nicoverduin/CoilWinder/README.md

CoilWinder
==========

Files to construct my ColiWinder project using 3D printing
