nicoverduin/CoilWinder/BOM.xls

Item | Part Number | Thumbnail | BOM Structure | Unit QTY | QTY | Stock Number | Project | Description | #test
16 | 10252 | (NonDisplayable) | Normal | 1 | 1
17 | 13190 | (NonDisplayable) | Normal | 1 | 1
18 | 18001 | (NonDisplayable) | Normal | 1 | 1
8 | 2793 | (NonDisplayable) | Normal | 1 | 1
63 | ANSI B18.6.5M - M3x0.5 x 16 | *Varies* | Purchased | 1 | 10 |  |  | Cross Recessed Pan Head Tapping Screw - Type D - Type IA - Metric
66 | Bearring cap 8mm | (NonDisplayable) | Normal | 1 | 4
23 | Compress Spring1 | *Varies* | Normal | 1 | 4
14 | DC Motor stand V2 | (NonDisplayable) | Normal | 1 | 1
15 | DC motor | (NonDisplayable) | Normal | 1 | 1
79 | Drive coupling | (NonDisplayable) | Normal | 1 | 1
67 | ISO 1224 - 39 - 3 x 8 x 4 | (NonDisplayable) | Purchased | 1 | 4 |  |  | Rolling bearings - Instrument precision bearings
57 | ISO 7091 - ST 4 - 100 HV | (NonDisplayable) | Purchased | 1 | 4 |  |  | Plain washers - Normal series - Product grade C
6 | JIS B 1521 SKF (D) - SKF 608-Z | (NonDisplayable) | Purchased | 1 | 8 |  |  | Deep groove ball bearings single row with Z shield SKF
53 | M3 Washer | (NonDisplayable) | Purchased | 1 | 27 |  |  | M3 Washer
56 | M3 nut nickel plated | (NonDisplayable) | Purchased | 1 | 17 |  |  | Hex M3 Nut
55 | M4 nut nickel plated | (NonDisplayable) | Purchased | 1 | 4 |  |  | Hex M4 nut
72 | Nema 17 stepper motor | (NonDisplayable) | Normal | 1 | 1
73 | Nema 17 support plate | (NonDisplayable) | Normal | 1 | 1
61 | Nut M3 Torque nickel plated | (NonDisplayable) | Purchased | 1 | 3 |  |  | Hex M3 nut Torque
5 | Nut M8 | *Varies* | Purchased | 1 | 103 |  |  | Hex Nut
24 | Sensor stand | (NonDisplayable) | Normal | 1 | 1
60 | Tension Push washer | (NonDisplayable) | Normal | 1 | 2
64 | Tension Push washer backplate | (NonDisplayable) | Normal | 1 | 2
59 | Tension knob | (NonDisplayable) | Normal | 1 | 2
74 | Thread rod M8 x 100 mm | (NonDisplayable) | Normal | 1 | 2 |  |  | 420.000 mm
3 | Thread rod M8 x 150 mm | (NonDisplayable) | Normal | 1 | 6 |  |  | 420.000 mm
10 | Thread rod M8 x 190 mm | (NonDisplayable) | Normal | 1 | 1 |  |  | 420.000 mm
77 | Thread rod M8 x 250 mm | (NonDisplayable) | Normal | 1 | 5 |  |  | 420.000 mm
75 | Thread rod M8 x 300 mm | (NonDisplayable) | Normal | 1 | 4 |  |  | 420.000 mm
80 | Thread rod M8 x 410 mm | (NonDisplayable) | Normal | 1 | 2 |  |  | 410.000 mm
1 | Vertex Bootm with foot | (NonDisplayable) | Normal | 1 | 6
27 | Vertex Bottom tensioner left | (NonDisplayable) | Normal | 1 | 1
51 | Vertex Bottom tensioner right | (NonDisplayable) | Normal | 1 | 1
58 | Washer M4 | (NonDisplayable) | Purchased | 1 | 2 |  |  | Plain washers - Normal series - Product grade C
4 | Washer M8 | *Varies* | Purchased | 1 | 102 |  |  | Washer
52 | Wire guidance base assembly | (NonDisplayable) | Normal | 1 | 1 |  |  | see: wire guidance base assemble.STL
65 | Wire guidance wheelV2 | (NonDisplayable) | Normal | 1 | 2 |  |  | See: wire guidance wheel.STL
78 | bolt M3 x 12 nickel plated | (NonDisplayable) | Purchased | 1 | 8 |  |  | Cross recessed pan head thread forming screws
62 | bolt M3 x 30 nickel plated | (NonDisplayable) | Purchased | 1 | 1 |  |  | bolt M3 x 30
20 | bolt M4 x 50 | *Varies* | Purchased | 1 | 4 |  |  | M4 bolt long enough to hold everything
71 | carriage | (NonDisplayable) | Normal | 1 | 1
19 | coil holder 1 | (NonDisplayable) | Normal | 1 | 2
21 | connect stepper | (NonDisplayable) | Normal | 1 | 2
54 | felt pad | (NonDisplayable) | Normal | 1 | 4 |  |  | felt pad i.e. used under chairs
69 | guidance wheel | (NonDisplayable) | Normal | 1 | 1
70 | lineair bearing 8 x15 x 24 | (NonDisplayable) | Normal | 1 | 2
25 | optical sensor pcb | (NonDisplayable) | Normal | 1 | 1
2 | right top | (NonDisplayable) | Normal | 1 | 3
29 | slide rod | (NonDisplayable) | Normal | 1 | 2
68 | wire guide | (NonDisplayable) | Normal | 1 | 1
