nicoverduin/CoilWinder/3D Print STL Files/Wire guidance base assembly.stl

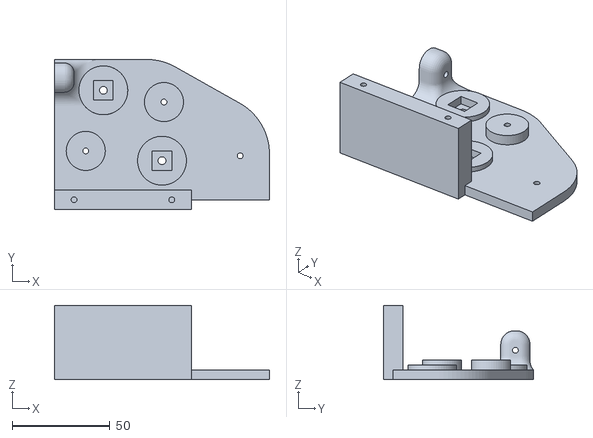
[picture p1: CAD file, 2014-01-01]
3D Print STL Files/Wire guidance base assembly.stl
110.0 x 76.8 x 38.0
