nicoverduin/CoilWinder/3D Print STL Files/Vertex Bottom tensioner right.stl

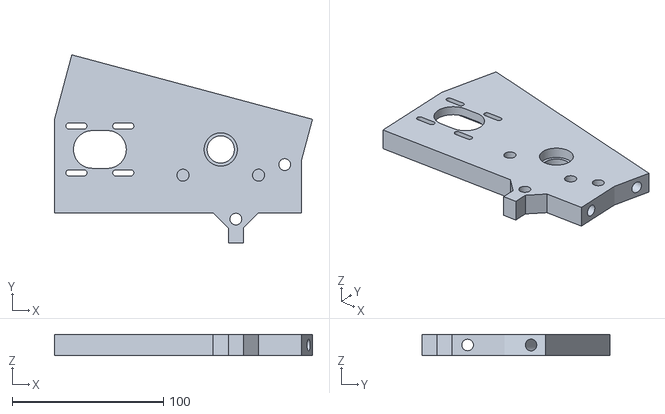
[picture p2: CAD file, 2014-01-01]
3D Print STL Files/Vertex Bottom tensioner right.stl
170.7 x 124.6 x 14.0
