nicoverduin/CoilWinder/3D Print STL Files/Tension knob.stl

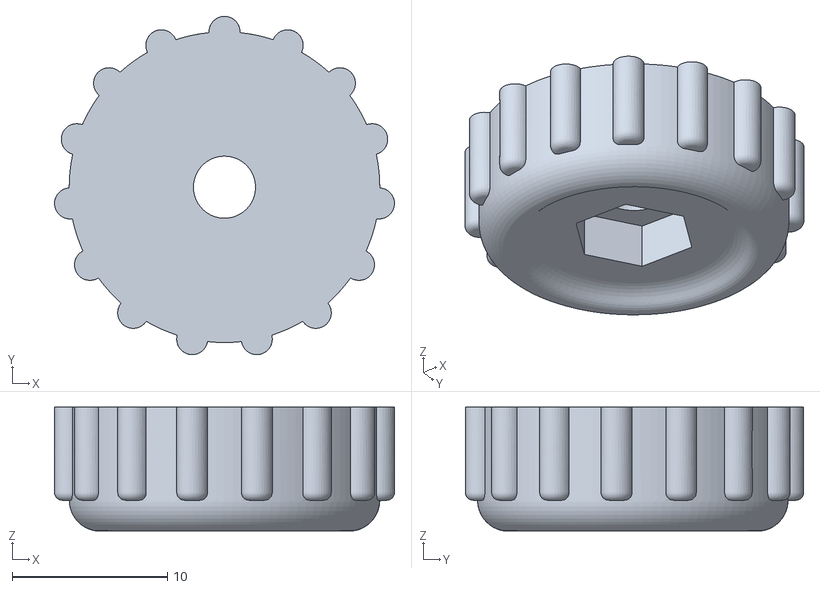
[picture p3: CAD file, 2014-01-01]
3D Print STL Files/Tension knob.stl
21.9 x 21.8 x 7.98
