nicoverduin/CoilWinder/3D Print STL Files/right top.stl

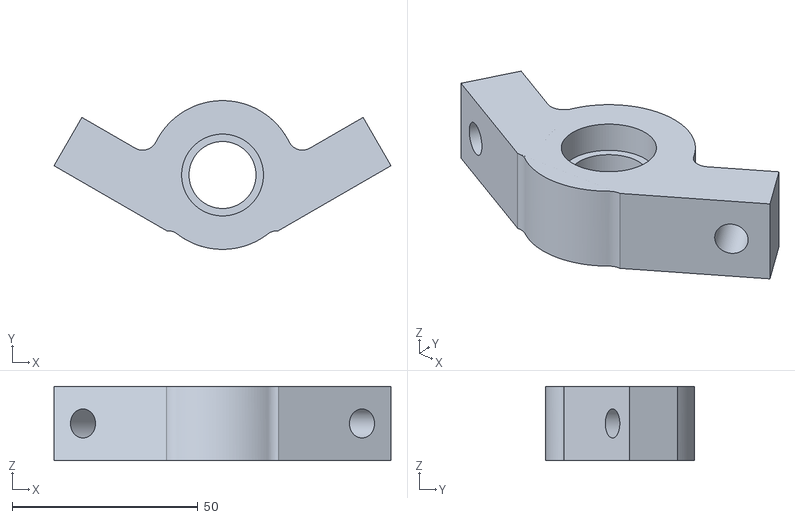
[picture p4: CAD file, 2014-01-01]
3D Print STL Files/right top.stl
90.6 x 40.0 x 20.0
