nicoverduin/CoilWinder/3D Print STL Files/DC Motor stand V2.stl

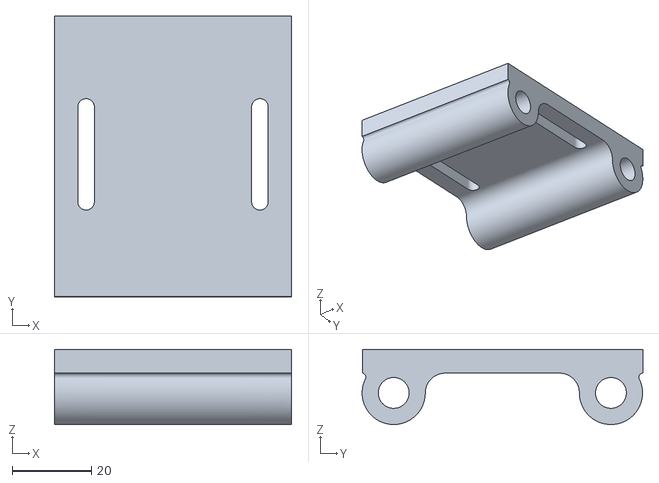
[picture p5: CAD file, 2014-01-01]
3D Print STL Files/DC Motor stand V2.stl
60.0 x 71.1 x 19.0
