nicoverduin/CoilWinder/3D Print STL Files/15-3m06m6ca6.stl

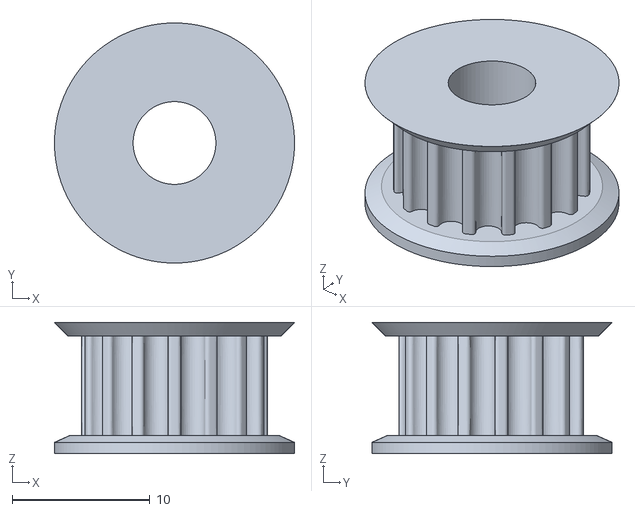
[picture p6: CAD file, 2014-01-01]
3D Print STL Files/15-3m06m6ca6.stl
17.4 x 17.4 x 9.50
