nicoverduin/CoilWinder/3D Print STL Files/Tensioner Pulley HTD 3 x 6 x 20.stl

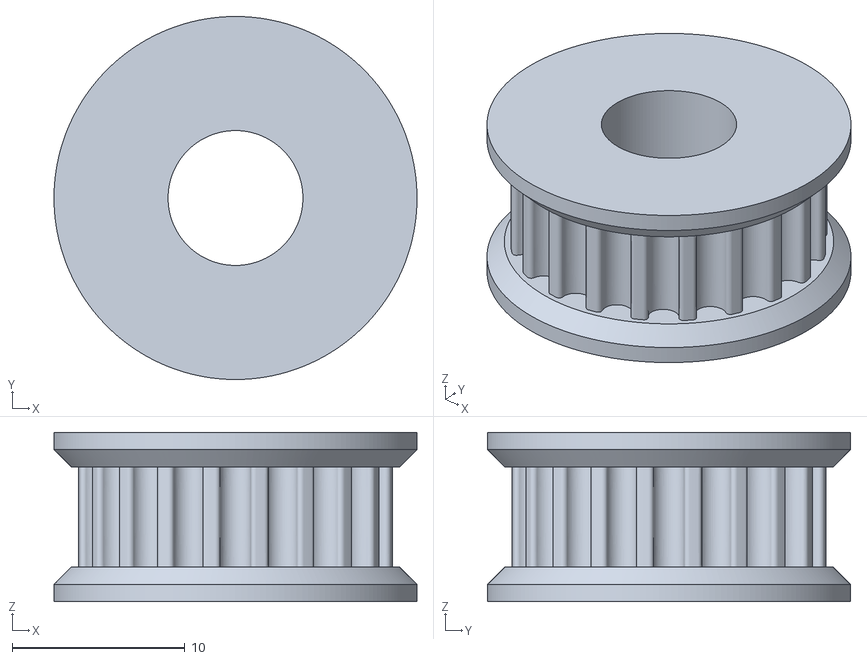
[picture p7: CAD file, 2014-01-01]
3D Print STL Files/Tensioner Pulley HTD 3 x 6 x 20.stl
21.0 x 21.0 x 9.80
