nicoverduin/CoilWinder/3D Print STL Files/connect stepper.stl

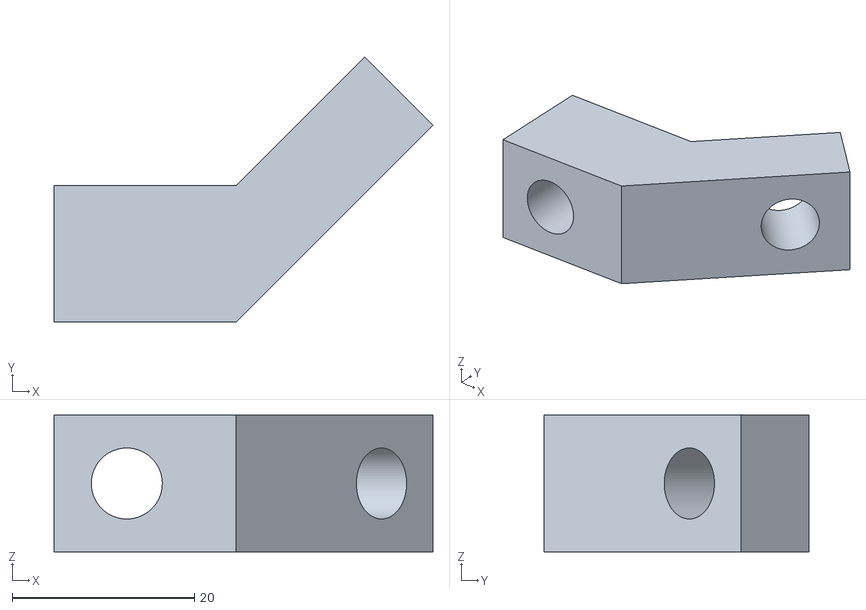
[picture p8: CAD file, 2014-01-01]
3D Print STL Files/connect stepper.stl
41.6 x 29.1 x 15.0
