nicoverduin/CoilWinder/3D Print STL Files/wire guide.stl

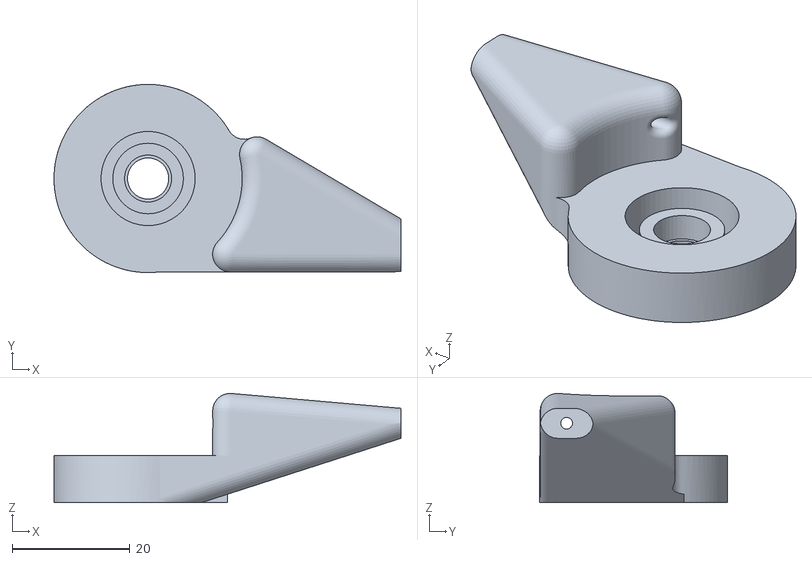
[picture p9: CAD file, 2014-01-01]
3D Print STL Files/wire guide.stl
59.0 x 32.0 x 18.6
