nicoverduin/CoilWinder/3D Print STL Files/guidance wheel.stl

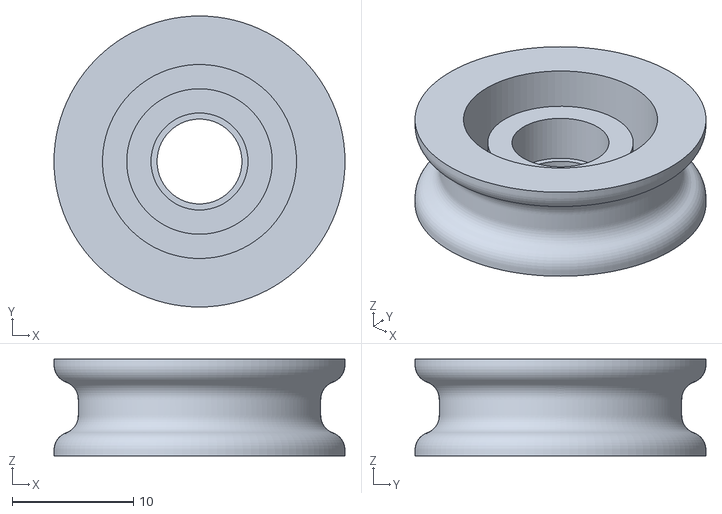
[picture p10: CAD file, 2014-01-01]
3D Print STL Files/guidance wheel.stl
24.0 x 24.0 x 8.00
