nicoverduin/CoilWinder/3D Print STL Files/28-3m06m6fa6.stl

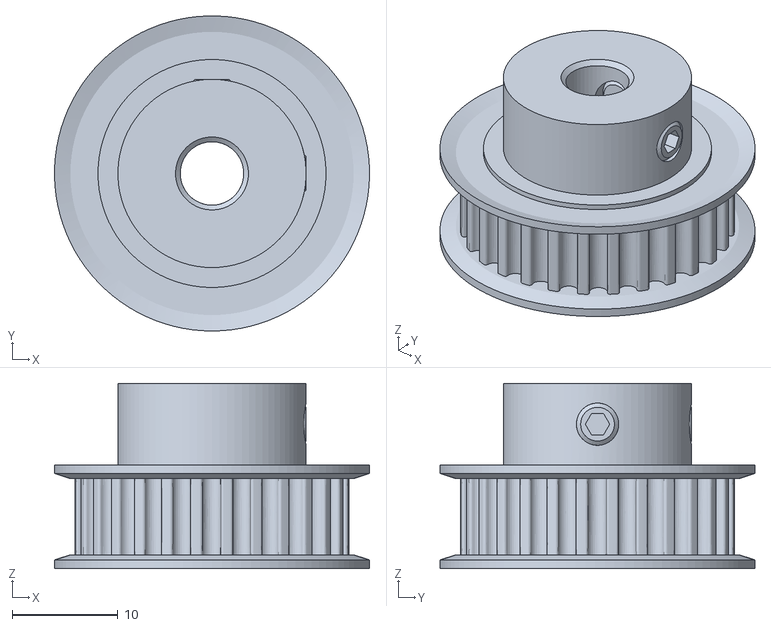
[picture p11: CAD file, 2014-01-01]
3D Print STL Files/28-3m06m6fa6.stl
29.8 x 29.8 x 17.5
