nicoverduin/CoilWinder/3D Print STL Files/Coil Coupling_2.stl

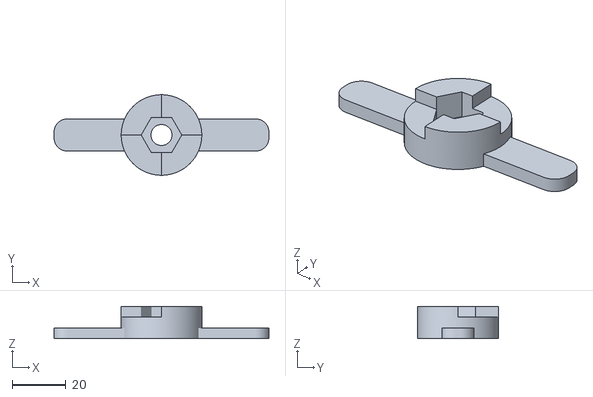
[picture p12: CAD file, 2014-01-01]
3D Print STL Files/Coil Coupling_2.stl
80.0 x 30.0 x 12.0
