nicoverduin/CoilWinder/3D Print STL Files/Vertex Bottom with foot.stl

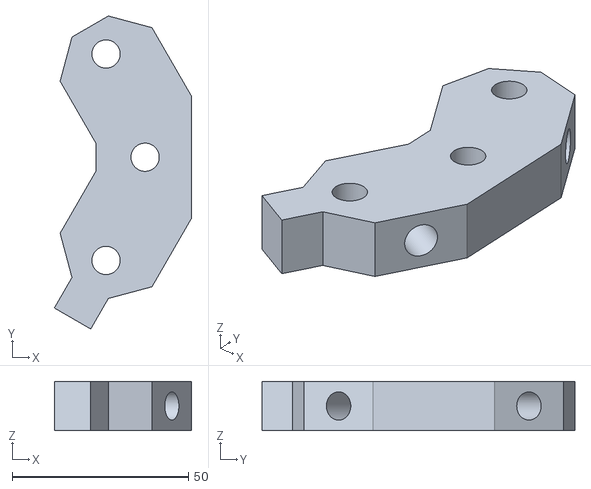
[picture p14: CAD file, 2014-01-01]
3D Print STL Files/Vertex Bottom with foot.stl
38.9 x 88.7 x 14.0
