nicoverduin/CoilWinder/3D Print STL Files/Bearring cap 8mm.stl

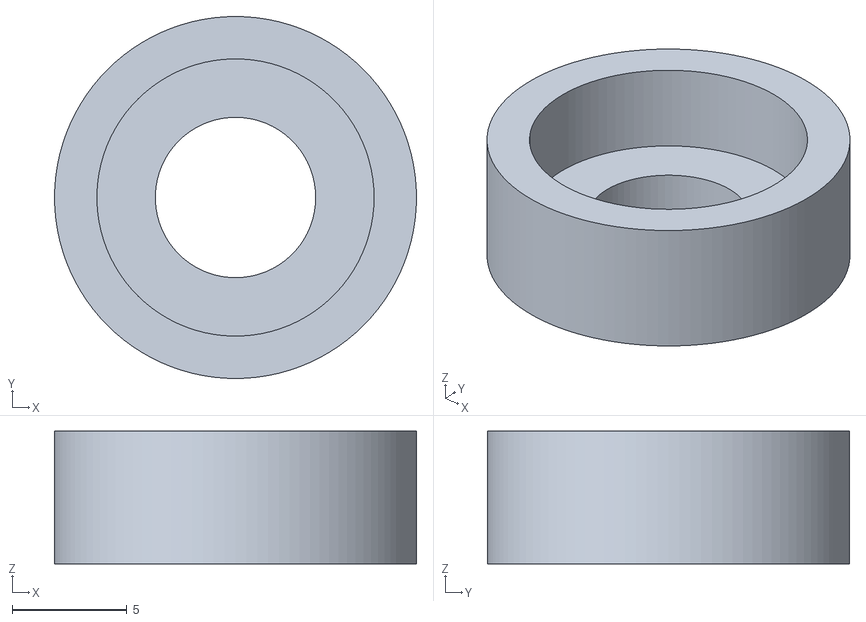
[picture p15: CAD file, 2014-01-01]
3D Print STL Files/Bearring cap 8mm.stl
15.8 x 15.8 x 5.80
