nicoverduin/CoilWinder/3D Print STL Files/Sensor stand.stl

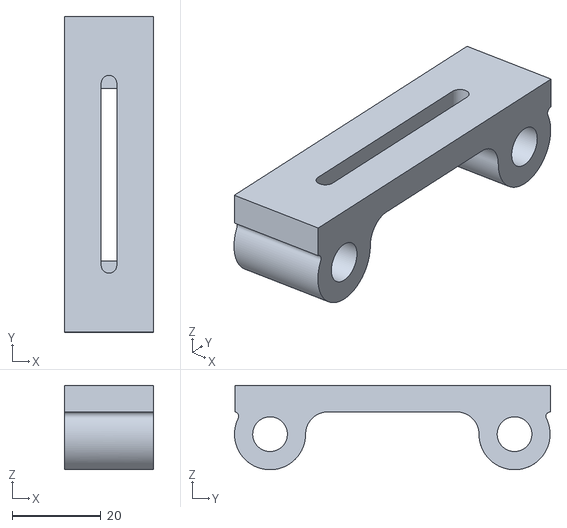
[picture p16: CAD file, 2014-01-01]
3D Print STL Files/Sensor stand.stl
20.0 x 71.1 x 19.0
