nicoverduin/CoilWinder/3D Print STL Files/Coil Coupling_1.stl

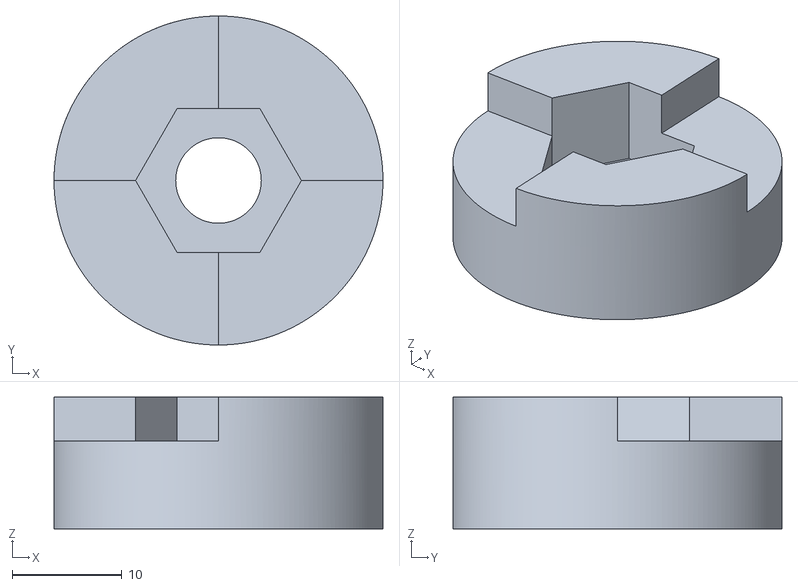
[picture p17: CAD file, 2014-01-01]
3D Print STL Files/Coil Coupling_1.stl
30.0 x 30.0 x 12.0
