nicoverduin/CoilWinder/3D Print STL Files/Vertex Bottom tensioner left.stl

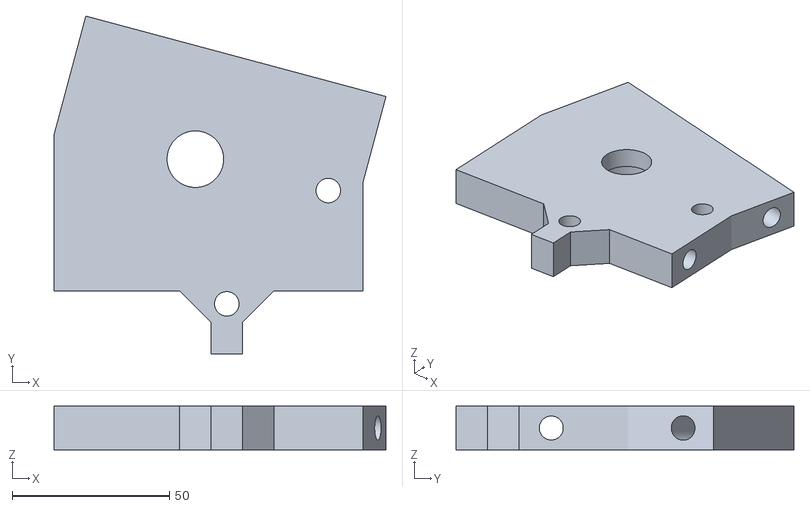
[picture p18: CAD file, 2014-01-01]
3D Print STL Files/Vertex Bottom tensioner left.stl
105.7 x 107.5 x 14.0
