nicoverduin/CoilWinder/3D Print STL Files/M3 HTD pulley D7.8.stl

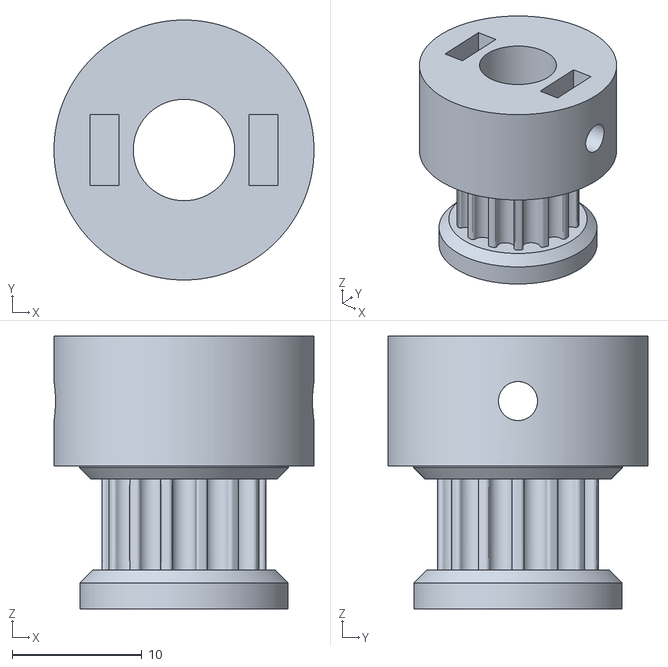
[picture p19: CAD file, 2014-01-01]
3D Print STL Files/M3 HTD pulley D7.8.stl
20.0 x 20.0 x 21.0
