nicoverduin/CoilWinder/3D Print STL Files/Wire guidance wheelV2.stl

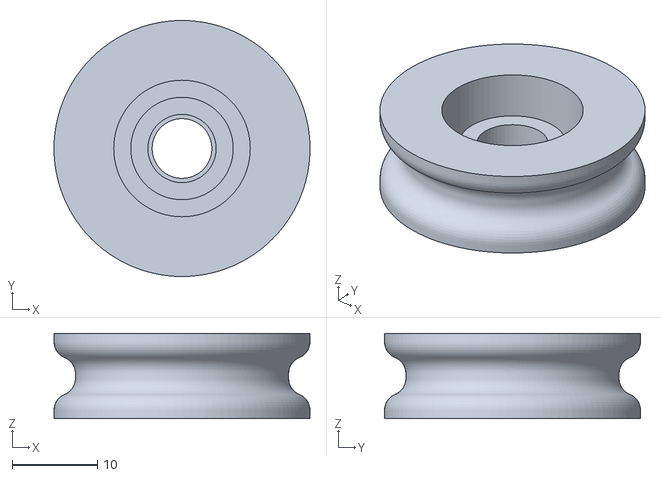
[picture p20: CAD file, 2014-01-01]
3D Print STL Files/Wire guidance wheelV2.stl
30.0 x 30.0 x 10.0
