nicoverduin/CoilWinder/3D Print STL Files/coil tightner.stl

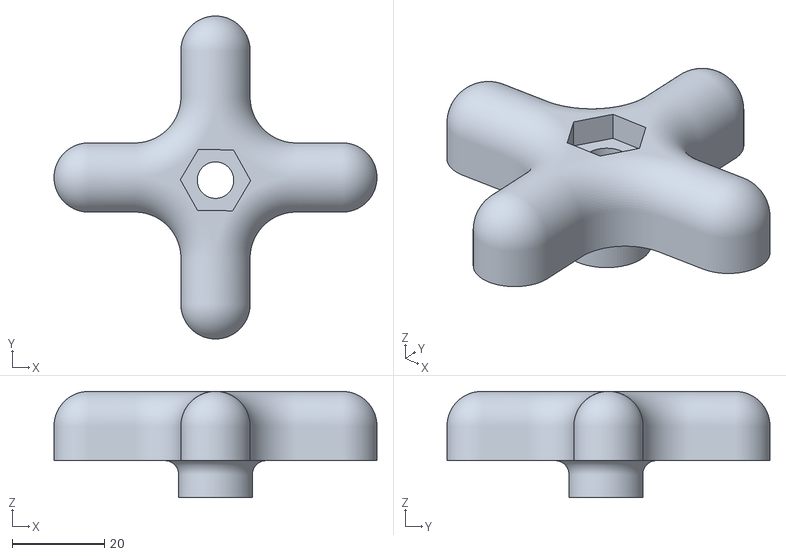
[picture p21: CAD file, 2014-01-01]
3D Print STL Files/coil tightner.stl
70.0 x 70.0 x 23.0
