nicoverduin/CoilWinder/3D Print STL Files/12-3m06m6ca4.stl

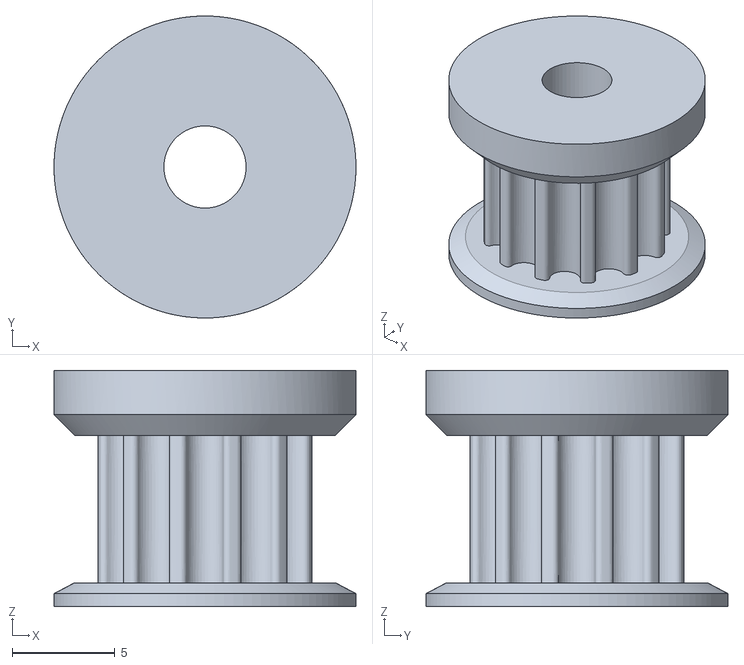
[picture p22: CAD file, 2014-01-01]
3D Print STL Files/12-3m06m6ca4.stl
14.7 x 14.7 x 11.5
