nicoverduin/CoilWinder/3D Print STL Files/carriage.stl

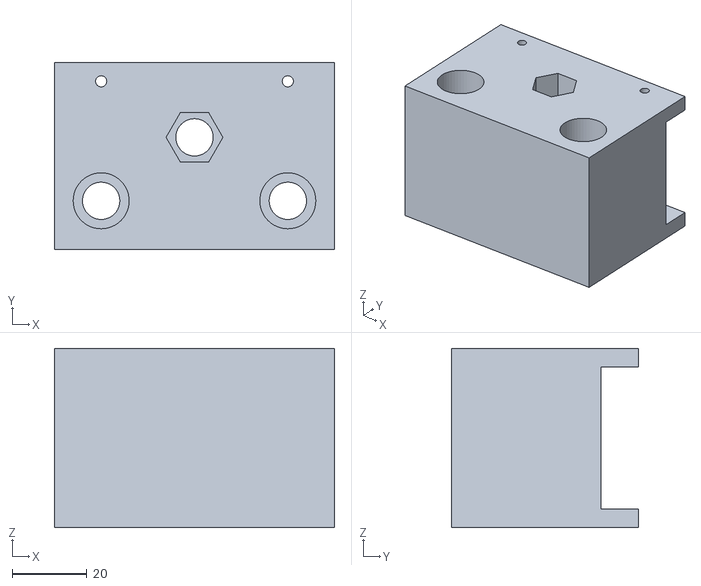
[picture p23: CAD file, 2014-01-01]
3D Print STL Files/carriage.stl
75.0 x 50.0 x 48.0
