nicoverduin/CoilWinder/(list of files, cad)

Other CAD files:
3D Print STL Files/Tension Push washer backplate.stl
3D Print STL Files/Tension Push washer.stl
AutoCad inventor Files 3D print/12-3m06m6ca4.ipt
AutoCad inventor Files 3D print/15-3m06m6ca6.ipt
AutoCad inventor Files 3D print/28-3m06m6fa6.ipt
AutoCad inventor Files 3D print/Bearing cap.ipt
AutoCad inventor Files 3D print/Coil Coupling_1.ipt
AutoCad inventor Files 3D print/Coil Coupling_2.ipt
AutoCad inventor Files 3D print/DC Motor stand V2.ipt
AutoCad inventor Files 3D print/Pulley HTD 3-40-7.8.ipt
AutoCad inventor Files 3D print/Sensor stand.ipt
AutoCad inventor Files 3D print/Stepper Pulley HTD 3 x 6 x 20.ipt
AutoCad inventor Files 3D print/Tension Push washer backplate.ipt
AutoCad inventor Files 3D print/Tension Push washer.ipt
AutoCad inventor Files 3D print/Tension knob.ipt
AutoCad inventor Files 3D print/Tensioner Pulley HTD 3 x 6 x 20.ipt
AutoCad inventor Files 3D print/Vertex Bottom tensioner left.ipt
AutoCad inventor Files 3D print/Vertex Bottom tensioner right.ipt
AutoCad inventor Files 3D print/Vertex Bottom with foot.ipt
AutoCad inventor Files 3D print/Wire guidance base assembly.ipt
AutoCad inventor Files 3D print/Wire guidance wheelV2.ipt
AutoCad inventor Files 3D print/carriage.ipt
AutoCad inventor Files 3D print/coil tightner.ipt
AutoCad inventor Files 3D print/connect stepper.ipt
AutoCad inventor Files 3D print/guidance wheel.ipt
AutoCad inventor Files 3D print/right top.ipt
AutoCad inventor Files 3D print/wire guide.ipt
AutoCad inventor Files Other parts/608ZZ bearing.ipt
AutoCad inventor Files Other parts/8mm thread 150 mm long.ipt
AutoCad inventor Files Other parts/Bearring cap 8mm.ipt
AutoCad inventor Files Other parts/Compress Spring1.iam
AutoCad inventor Files Other parts/Compress Spring11.ipt
AutoCad inventor Files Other parts/DC motor.ipt
AutoCad inventor Files Other parts/Drive thread.ipt
AutoCad inventor Files Other parts/Half Nut M8.ipt
AutoCad inventor Files Other parts/ISO 1224 - 39 - 3 x 8 x 4.ipt
AutoCad inventor Files Other parts/M3 x 12 nickel plated.ipt
AutoCad inventor Files Other parts/M4 Carre Washer Nickel plated.ipt
AutoCad inventor Files Other parts/M4 Washer Nickel plated.ipt
AutoCad inventor Files Other parts/Nema 17 stepper motor.ipt
AutoCad inventor Files Other parts/Nut M3 Torque nickel plated.ipt
AutoCad inventor Files Other parts/Nut M3 nickel plated.ipt
AutoCad inventor Files Other parts/Nut M4 nickel plated.ipt
AutoCad inventor Files Other parts/Nut M8.ipt
AutoCad inventor Files Other parts/Thread rod M8 x 100 mm.ipt
AutoCad inventor Files Other parts/Thread rod M8 x 150 mm.ipt
AutoCad inventor Files Other parts/Thread rod M8 x 190 mm.ipt
AutoCad inventor Files Other parts/Thread rod M8 x 200 mm.ipt
AutoCad inventor Files Other parts/Thread rod M8 x 220 mm.ipt
AutoCad inventor Files Other parts/Thread rod M8 x 230 mm.ipt
AutoCad inventor Files Other parts/Thread rod M8 x 250 mm.ipt
AutoCad inventor Files Other parts/Thread rod M8 x 300 mm.ipt
AutoCad inventor Files Other parts/Thread rod M8 x 360 mm.ipt
AutoCad inventor Files Other parts/Thread rod M8 x 380 mm.ipt
AutoCad inventor Files Other parts/Thread rod M8 x 410 mm.ipt
AutoCad inventor Files Other parts/Thread rod M8 x 419 mm.ipt
AutoCad inventor Files Other parts/Thread rod M8 x 420 mm.ipt
AutoCad inventor Files Other parts/Washer M3 nickel plated.ipt
AutoCad inventor Files Other parts/Washer M4.ipt
AutoCad inventor Files Other parts/Washer M8.ipt
AutoCad inventor Files Other parts/bolt M3 x 12 nickel plated.ipt
AutoCad inventor Files Other parts/bolt M3 x 16 nickel plated.ipt
AutoCad inventor Files Other parts/bolt M3 x 20 nickel plated.ipt
AutoCad inventor Files Other parts/bolt M3 x 25 nickel plated.ipt
AutoCad inventor Files Other parts/bolt M3 x 30 nickel plated.ipt
AutoCad inventor Files Other parts/bolt M4 x 10 nickel plated.ipt
AutoCad inventor Files Other parts/bolt M4 x 70 nickel plated.ipt
AutoCad inventor Files Other parts/carre Washer M8.ipt
AutoCad inventor Files Other parts/felt.ipt
AutoCad inventor Files Other parts/lineair bearing 8 x15 x 24.ipt
AutoCad inventor Files Other parts/optical sensor pcb.ipt
AutoCad inventor Files Other parts/slide rod.ipt
AutoCad inventor Files assemblies/Motor assembly V2.iam
AutoCad inventor Files assemblies/Nut+Washer M8.iam
AutoCad inventor Files assemblies/Winder Assembly 1.iam
AutoCad inventor Files assemblies/Wire tension assembly.iam
AutoCad inventor Files assemblies/coil winder V2.iam
AutoCad inventor Files assemblies/coil winder V2.ipn
AutoCad inventor Files assemblies/guide wheel.iam
AutoCad inventor Files assemblies/wire guidance wheel.iam
AutoCad inventor Files assemblies/wire guidance.iam
coil winder V2.idw
