nicoverduin/CoilWinder/coil winder V2.pdf

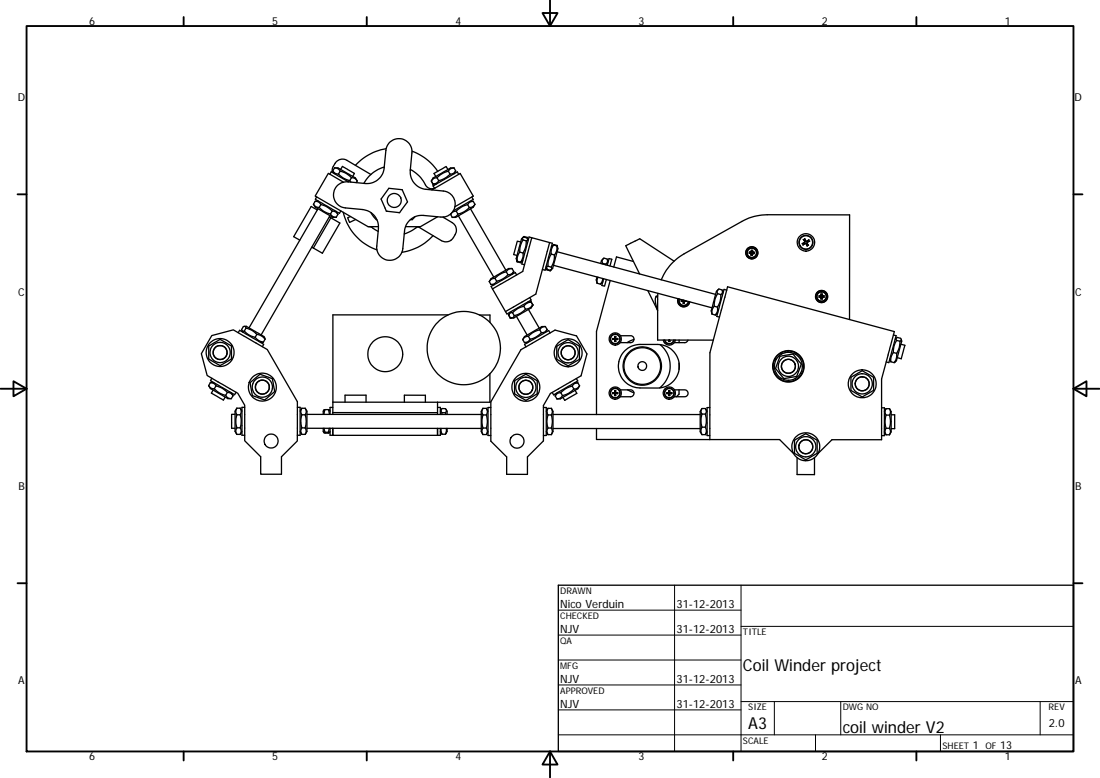
[picture p24: page 1]
DWG NO

DRAWN Nico Verduin | 31-12-2013

CHECKED NJV | 31-12-2013

TITLE
Coil Winder project

MFG NJV | 31-12-2013

APPROVED NJV

SIZE A3 | coil winder V2 | REV

SCALE | | SHEET 1 OF 13

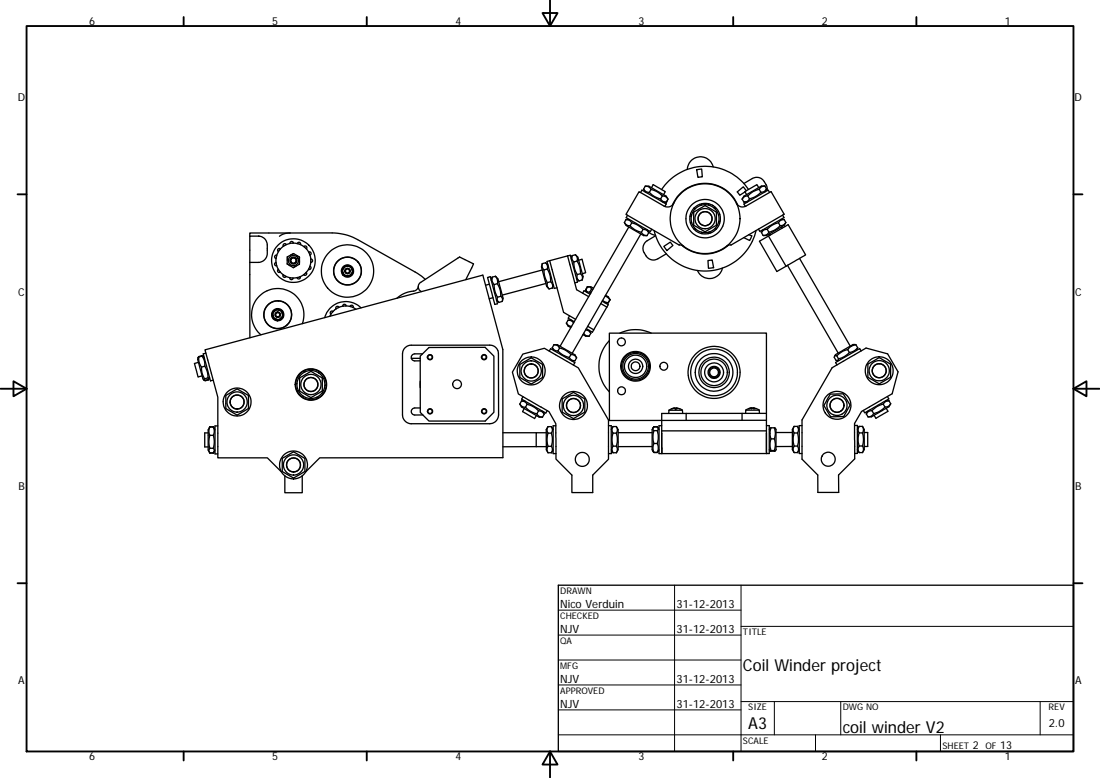
[picture p25: page 2]
DWG NO; SIZE; REV

DRAWN Nico Verduin | 31-12-2013

CHECKED NJV | 31-12-2013

TITLE
Coil Winder project

MFG NJV | 31-12-2013

APPROVED NJV

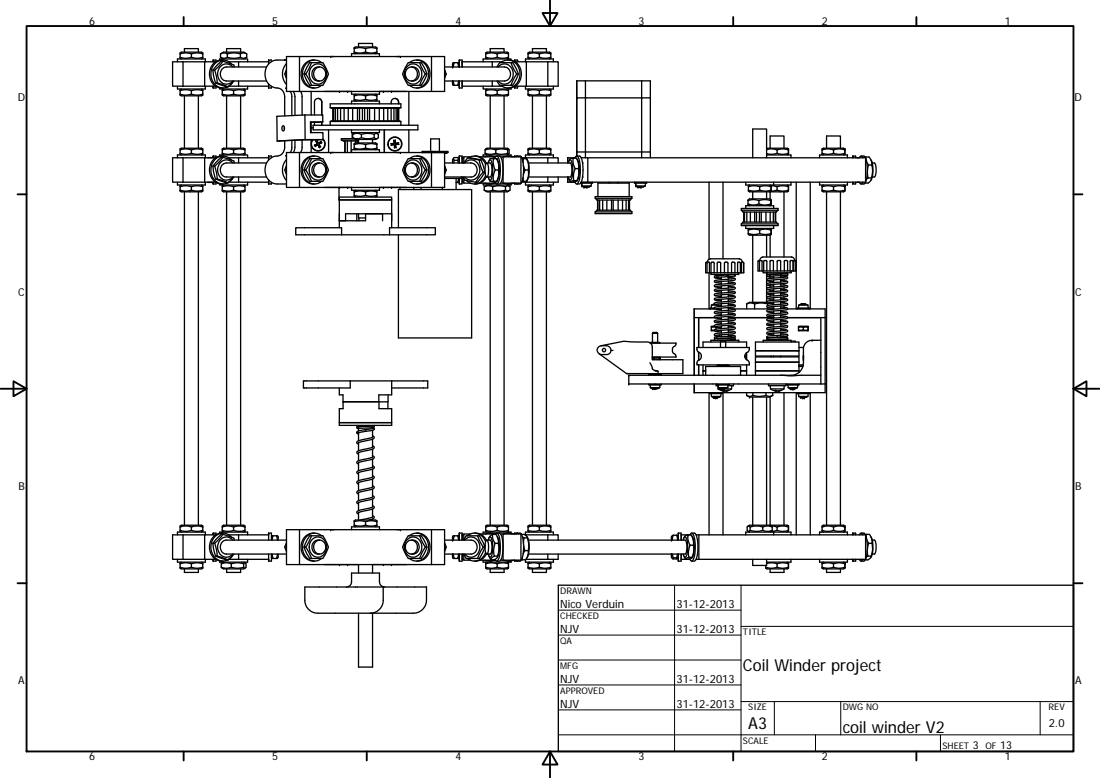
[picture p26: page 3]
DRAWN; CHECKED; MFG; APPROVED NJV; NJV; Nico Verduin; DWG NO; SIZE; REV

TITLE
Coil Winder project

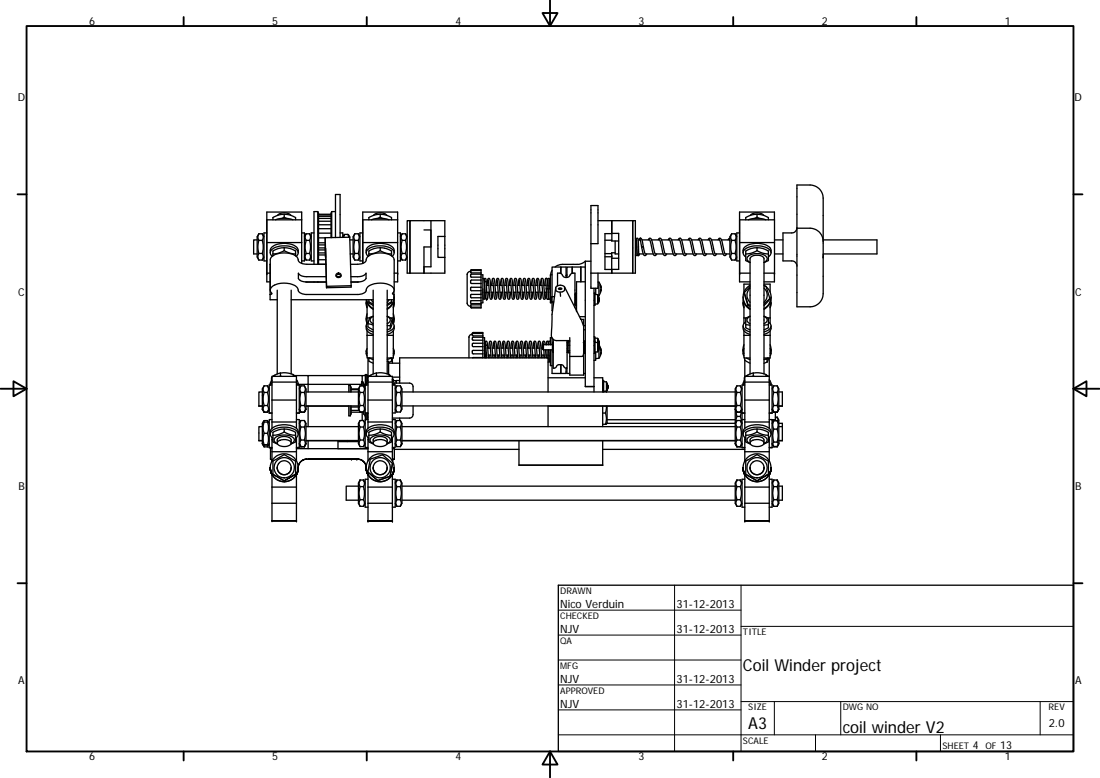
[picture p27: page 4]
DRAWN; CHECKED; MFG; APPROVED NJV; NJV; Nico Verduin; DWG NO; SIZE; REV

TITLE
Coil Winder project

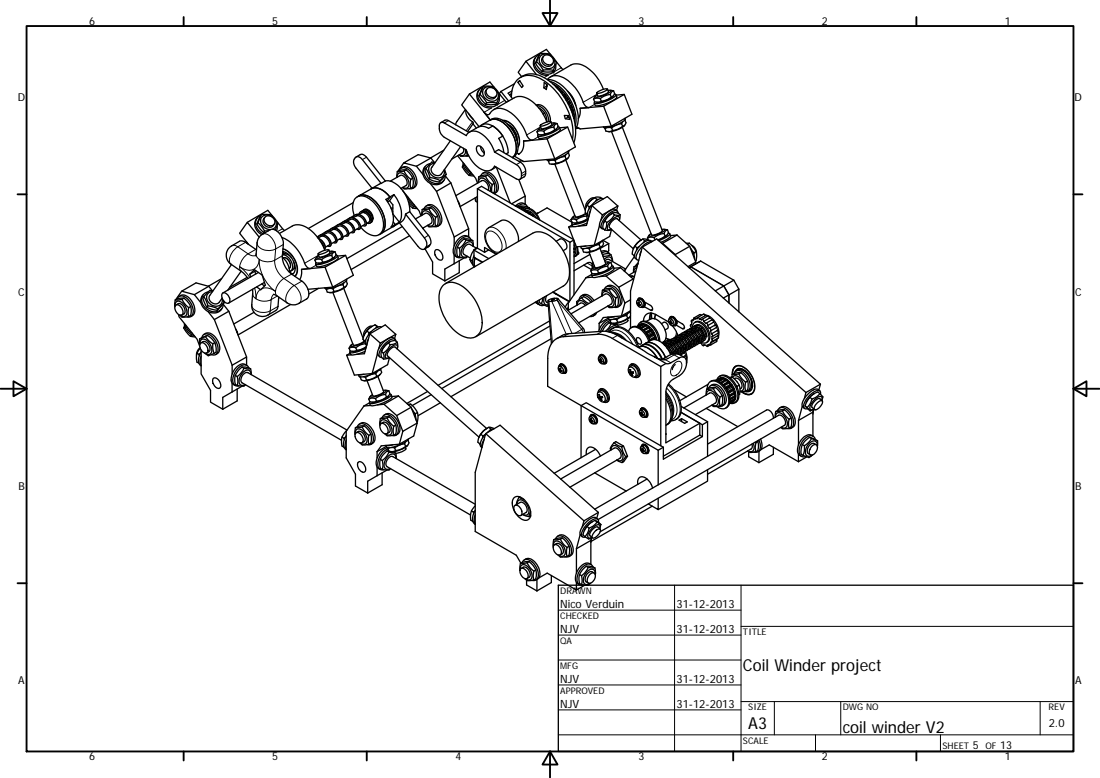
[picture p28: page 5]
DWG NO; SIZE; REV

DRAWN Nico Verduin | 31-12-2013

CHECKED NJV | 31-12-2013

TITLE
Coil Winder project

MFG NJV | 31-12-2013

APPROVED NJV

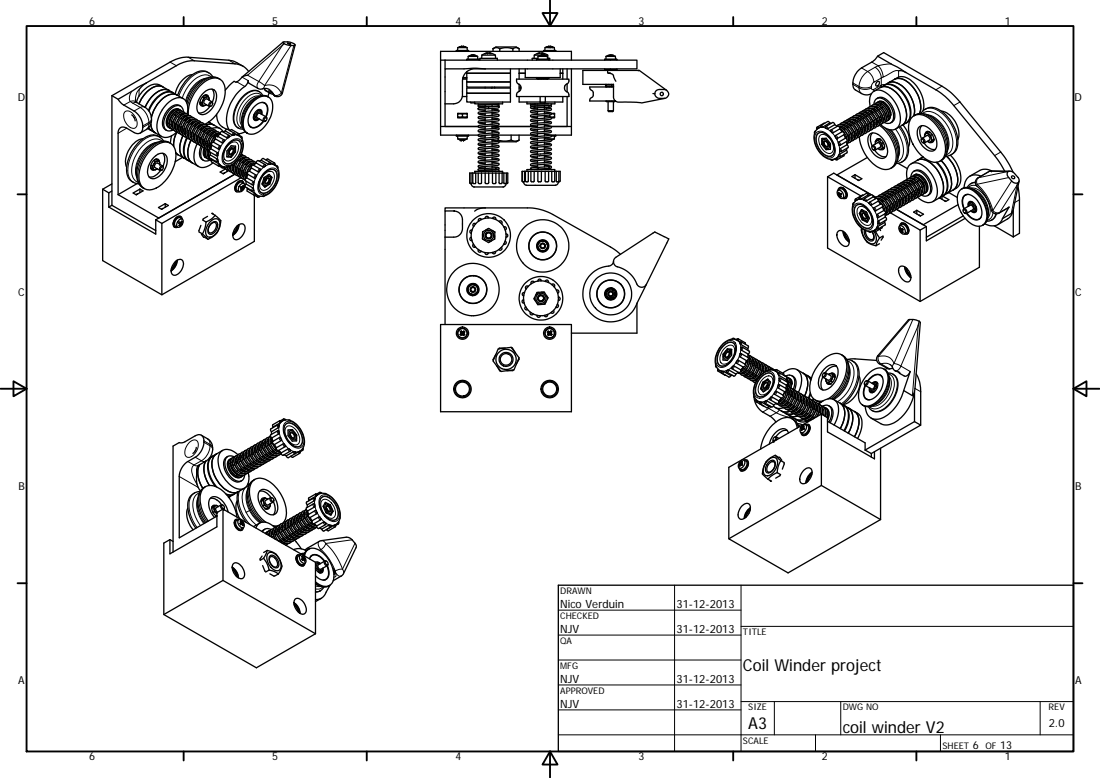
[picture p29: page 6]
DRAWN; CHECKED; MFG; APPROVED NJV; NJV; Nico Verduin; DWG NO; SIZE; REV

TITLE
Coil Winder project

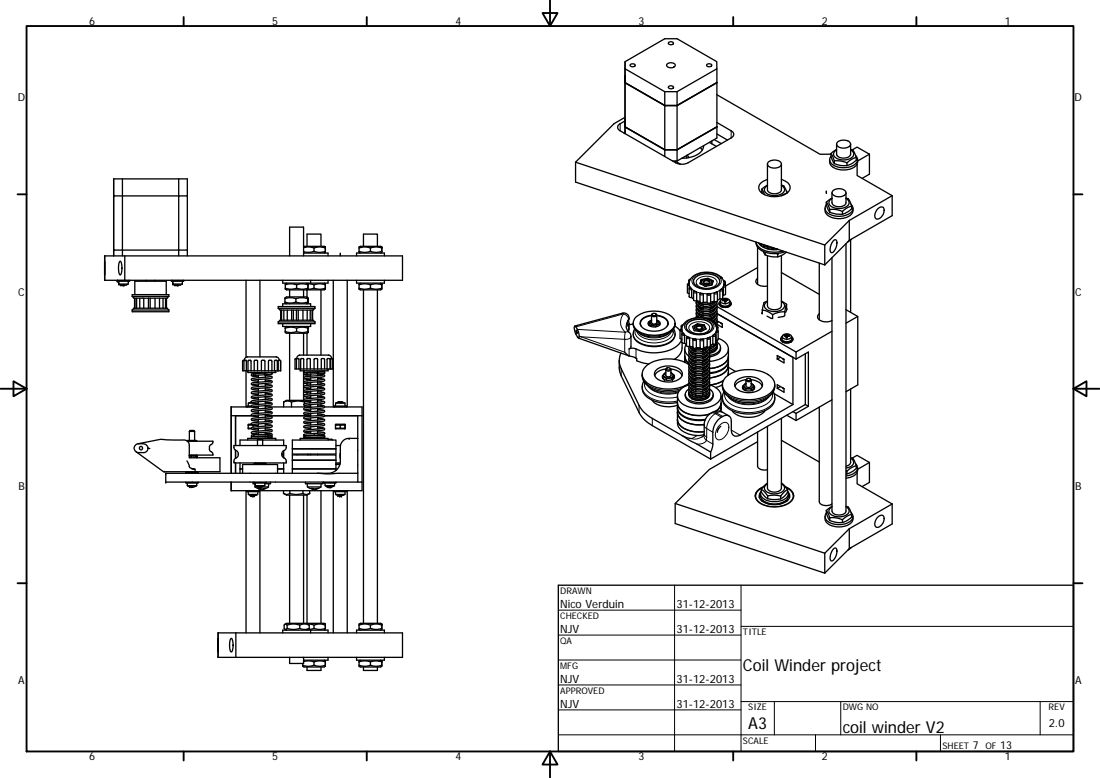
[picture p30: page 7]
DRAWN; CHECKED; MFG; APPROVED NJV; NJV; Nico Verduin; DWG NO; SIZE; REV

TITLE
Coil Winder project

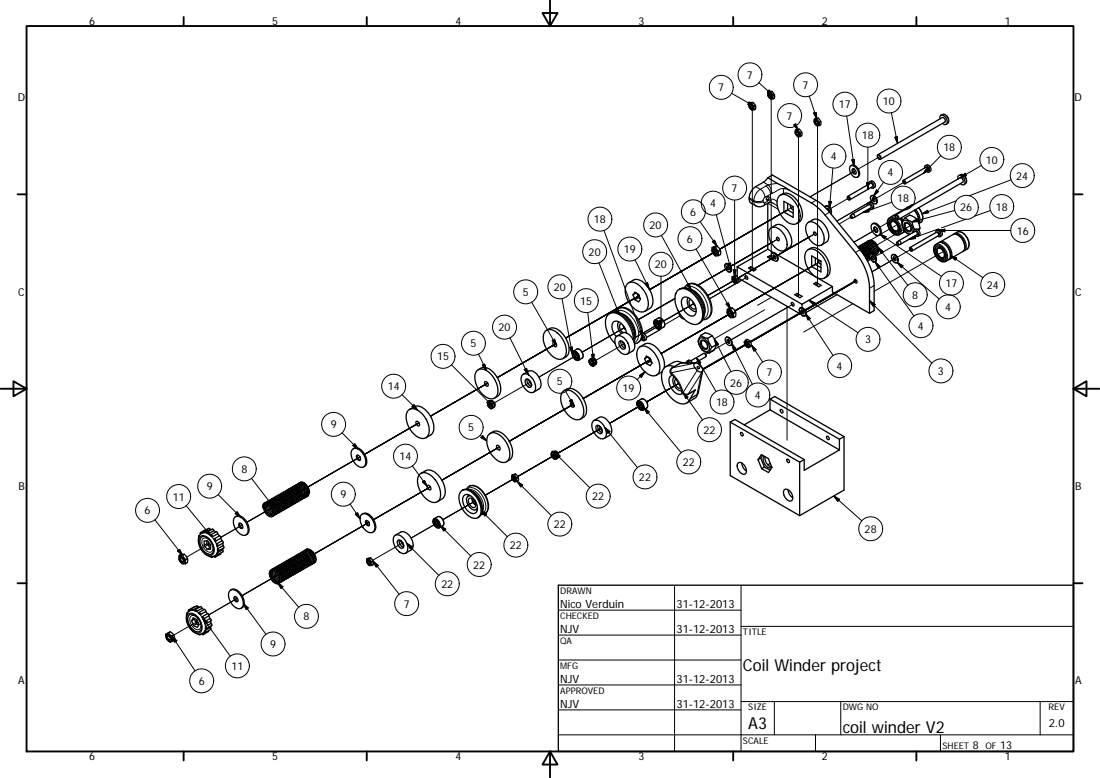
[picture p31: page 8]
DWG NO; SIZE; REV

DRAWN Nico Verduin | 31-12-2013

CHECKED NJV | 31-12-2013

TITLE
Coil Winder project

MFG NJV | 31-12-2013

APPROVED NJV

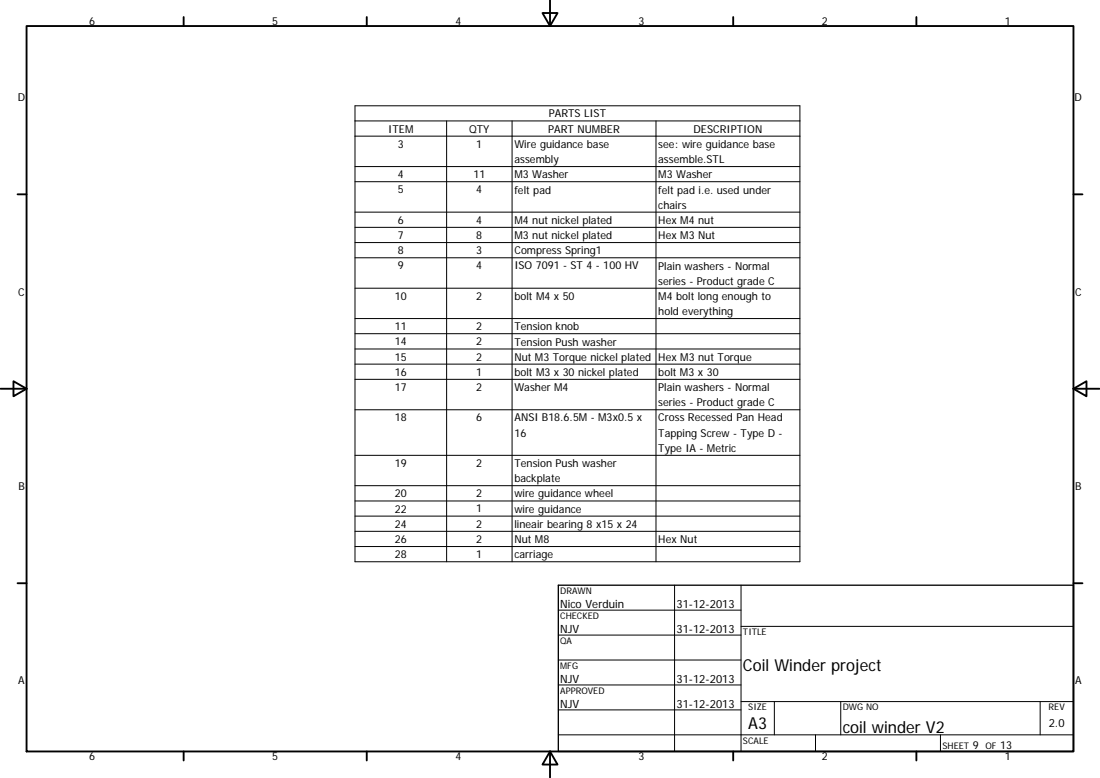
[picture p32: page 9]
DWG NO; SIZE; REV; PARTS LIST

ITEM | QTY | PART NUMBER | DESCRIPTION
3 | 1 | Wire guidance base assembly | see: wire guidance base assemble.STL

4 | 11 | M3 Washer | M3 Washer
5 | 4 | felt pad | felt pad i.e. used under chairs

6 | 4 | M4 nut nickel plated | Hex M4 nut
7 | 8 | M3 nut nickel plated | Hex M3 Nut
8 | 3 | Compress Spring1
9 | 4 | ISO 7091 - ST 4 - 100 HV | Plain washers - Normal series - Product grade C

10 | 2 | bolt M4 x 50 | M4 bolt long enough to hold everything

11 | 2 | Tension knob
14 | 2 | Tension Push washer
15 | 2 | Nut M3 Torque nickel plated | Hex M3 nut Torque
16 | 1 | bolt M3 x 30 nickel plated | bolt M3 x 30
17 | 2 | Washer M4 | Plain washers - Normal series - Product grade C

18 | 6 | ANSI B18.6.5M - M3x0.5 x 16 | Cross Recessed Pan Head Tapping Screw - Type D -Type IA - Metric

19 | 2 | Tension Push washer backplate

20 | 2 | wire guidance wheel
22 | 1 | wire guidance
24 | 2 | lineair bearing 8 x15 x 24
26 | 2 | Nut M8 | Hex Nut
28 | 1 | carriage

DRAWN Nico Verduin | 31-12-2013

CHECKED NJV | 31-12-2013

TITLE
Coil Winder project

MFG NJV | 31-12-2013

APPROVED NJV

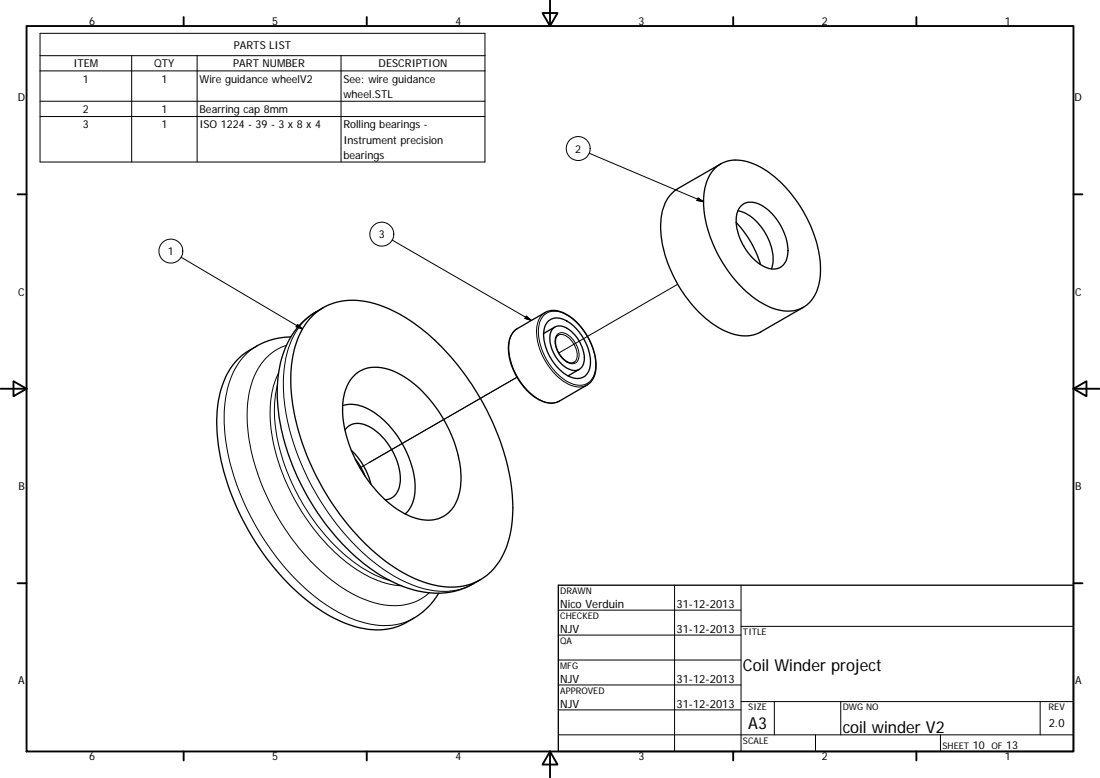
[picture p33: page 10]
DWG NO; SIZE; REV; PARTS LIST

ITEM | QTY | PART NUMBER | DESCRIPTION
1 | 1 | Wire guidance wheelV2 | See: wire guidance wheel.STL

2 | 1 | Bearring cap 8mm
3 | 1 | ISO 1224 - 39 - 3 x 8 x 4 | Rolling bearings -Instrument precision bearings

DRAWN Nico Verduin | 31-12-2013

CHECKED NJV | 31-12-2013

TITLE
Coil Winder project

MFG NJV | 31-12-2013

APPROVED NJV

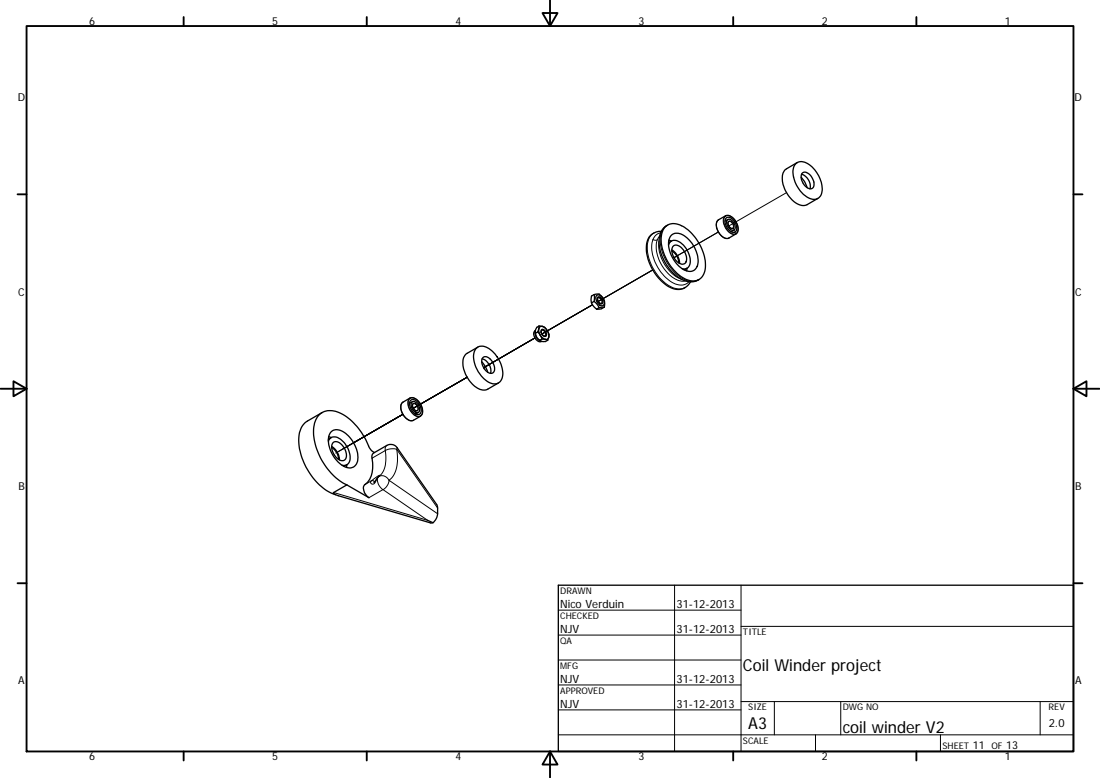
[picture p34: page 11]
DWG NO; SIZE; REV

DRAWN Nico Verduin | 31-12-2013

CHECKED NJV | 31-12-2013

TITLE
Coil Winder project

MFG NJV | 31-12-2013

APPROVED NJV

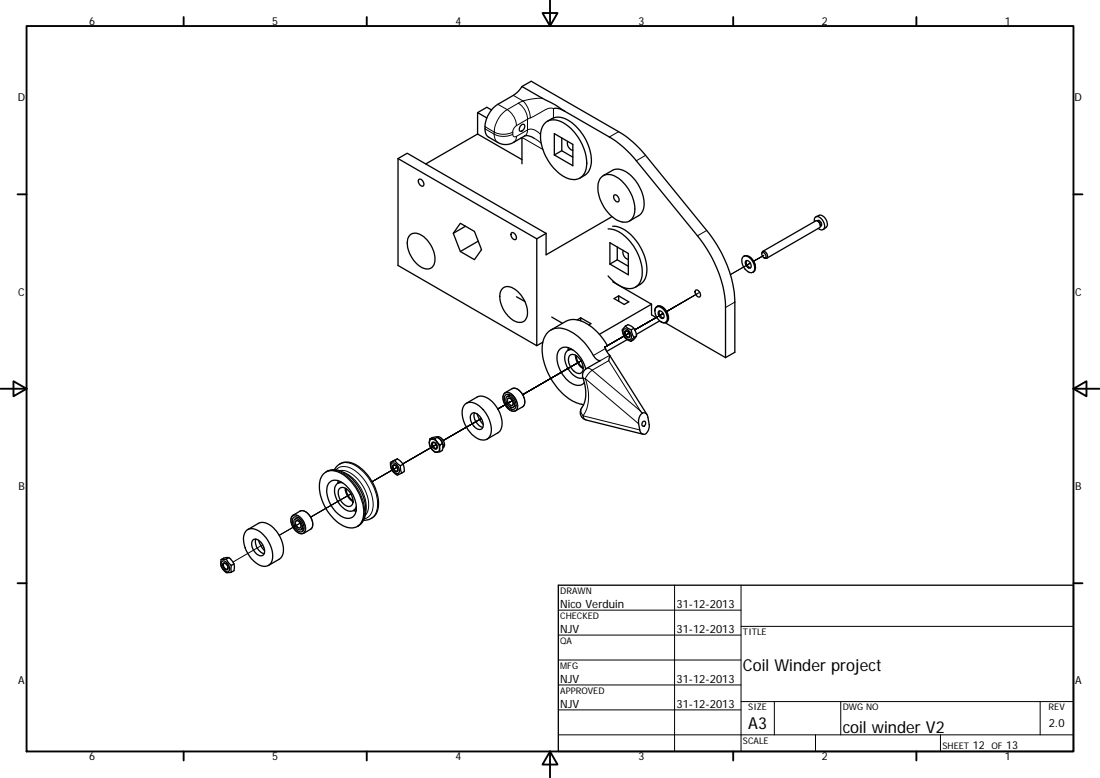
[picture p35: page 12]
DWG NO; SIZE; REV

DRAWN Nico Verduin | 31-12-2013

CHECKED NJV | 31-12-2013

TITLE
Coil Winder project

MFG NJV | 31-12-2013

APPROVED NJV

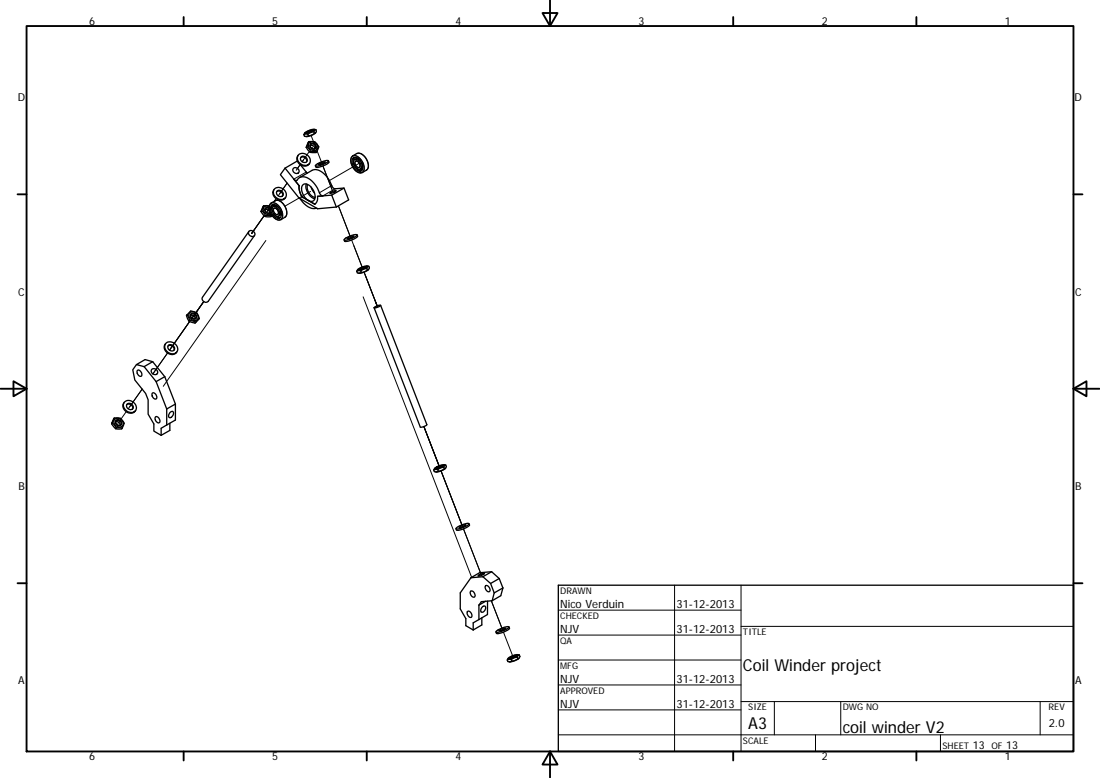
[picture p36: page 13]
DWG NO; SIZE; REV

DRAWN Nico Verduin | 31-12-2013

CHECKED NJV | 31-12-2013

TITLE
Coil Winder project

MFG NJV | 31-12-2013

APPROVED NJV
