nicoverduin/CoilWinder/(commit log)

2013-12-31 Initial load
    [12-3m06m6ca4.ipt, 15-3m06m6ca6.ipt, 28-3m06m6fa6.ipt, 608ZZ bearing.ipt, Bearing cap.ipt, Coil Coupling_1.ipt, Coil Coupling_2.ipt, Compress Spring11.ipt]
2014-01-01 Initial upload and updated drawings
    [12-3m06m6ca4.stl, 15-3m06m6ca6.stl, 28-3m06m6fa6.stl, BOM.xls, Bearring cap 8mm.stl, Coil Coupling_1.stl, Coil Coupling_2.stl, DC Motor stand V2.stl]
2014-12-10 Missing part
    Added drive thread ipt
    [Drive thread.ipt]
2014-12-10 more missing parts
    [8mm thread 150 mm long.ipt, Bearring cap 8mm.ipt, Compress Spring1.iam, ISO 1224 - 39 - 3 x 8 x 4.ipt, M4 Carre Washer Nickel plated.ipt, M4 Washer Nickel plated.ipt, carre Washer M8.ipt]
